nnorbik/robot_soubory/seznam_STL.pdf

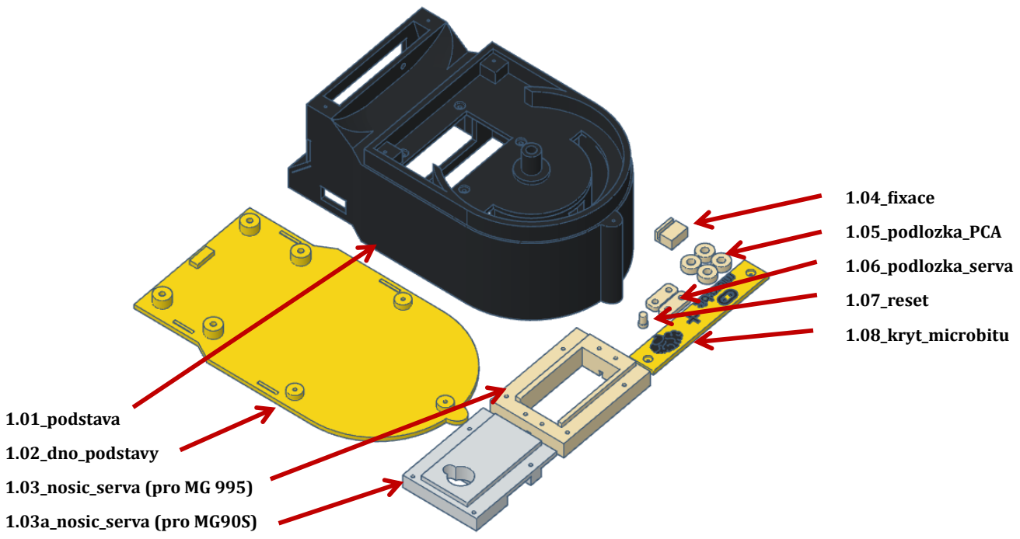
[picture p7: page 1]

1.01_podstava

1.02_dno_podstavy

1.03_nosic_serva (pro MG 995)

1.03a_nosic_serva (pro MG90S)

1.04_fixace

1.05_podlozka_PCA

1.06_podlozka_serva

1.07_reset

1.08_kryt_microbitu

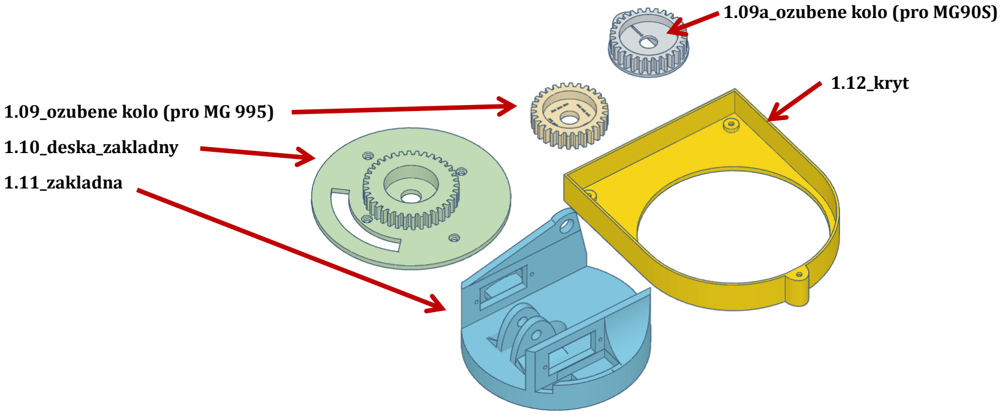
[picture p8: figure]
1.09_ozubene kolo (pro MG 995); 1.10_deska_zakladny; 1.11_zakladna; 1.09a_ozubene kolo (pro MG90S); 1.12_kryt
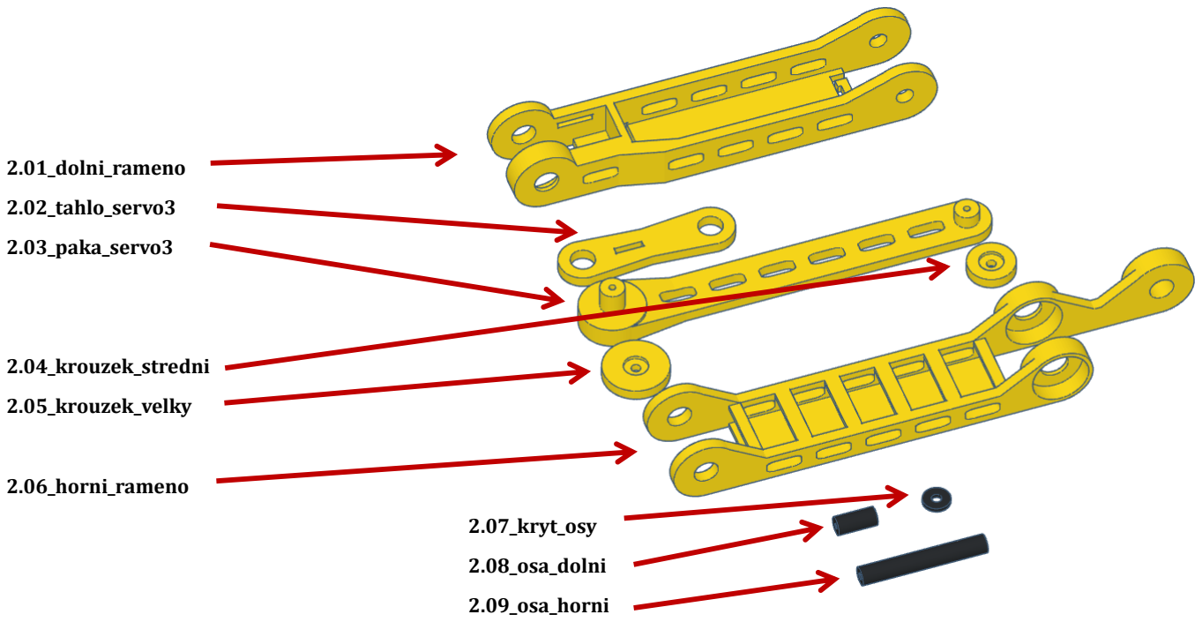
[picture p9: page 3]

2.01_dolni_rameno

2.02_tahlo_servo3

2.03_paka_servo3

2.04_krouzek_stredni

2.05_krouzek_velky

2.06_horni_rameno

2.07_kryt_osy

2.08_osa_dolni

2.09_osa_horni

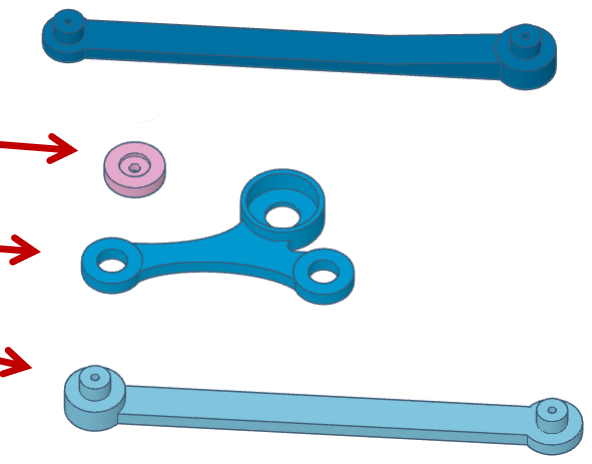
[picture p10: figure]

2.10_fix__dolni

2.11_krouzek_maly

2.12_paka

2.13_fix_horni

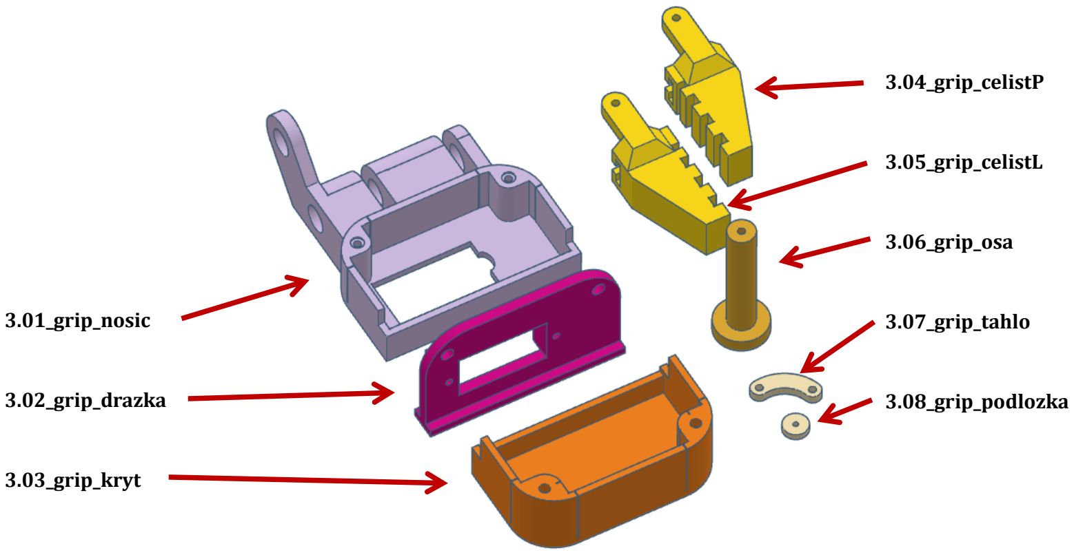
[picture p11: figure]
3.01_grip_nosic; 3.02_grip_drazka; 3.03_grip_kryt; 3.04_grip_celistP; 3.05_grip_celistL; 3.06_grip_osa; 3.07_grip_tahlo; 3.08_grip_podlozka
