nnorbik/robot_soubory/objekty/rampa.stl

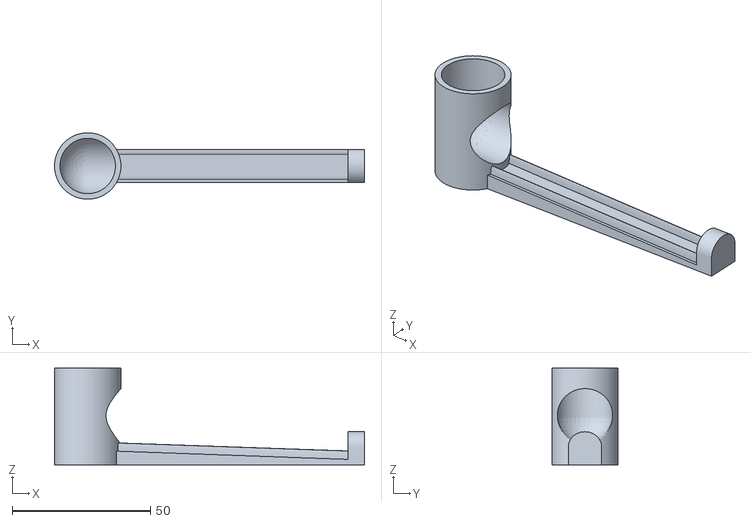
[picture p12: CAD file, 2023-05-19]
objekty/rampa.stl
112.0 x 24.0 x 35.0
