nnorbik/robot_soubory/STL/2.03_paka_servo3.stl

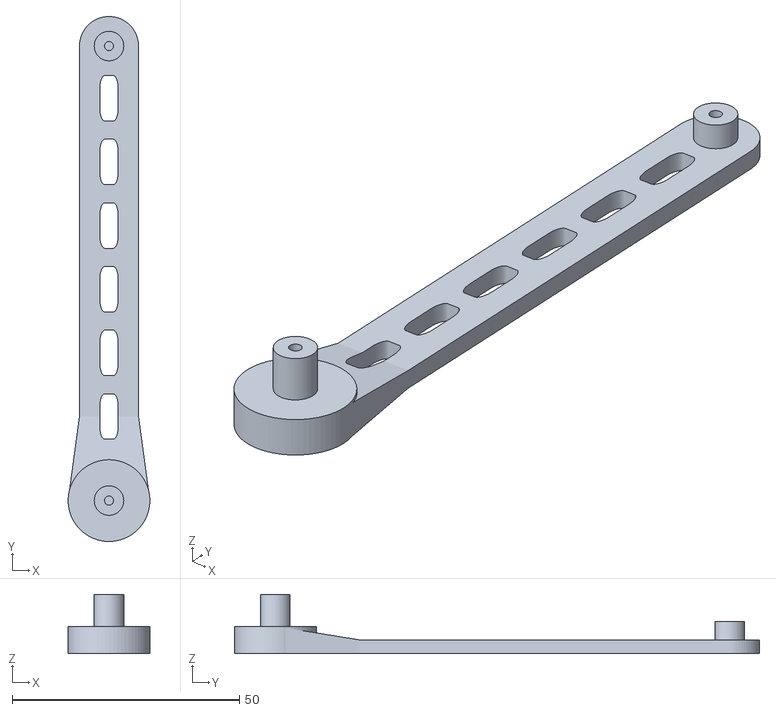
[picture p13: CAD file, 2023-04-25]
STL/2.03_paka_servo3.stl
18.0 x 115.5 x 13.0
