nnorbik/robot_soubory/objekty/zarazka.stl

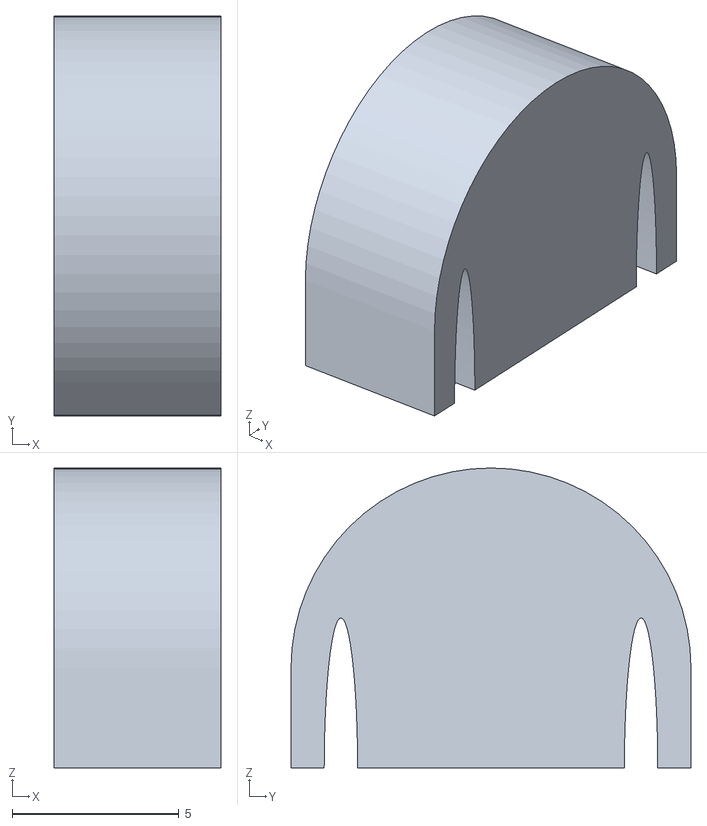
[picture p14: CAD file, 2023-05-19]
objekty/zarazka.stl
5.00 x 12.0 x 9.00
