nnorbik/robot_soubory/STL/2.07_kryt osy.stl

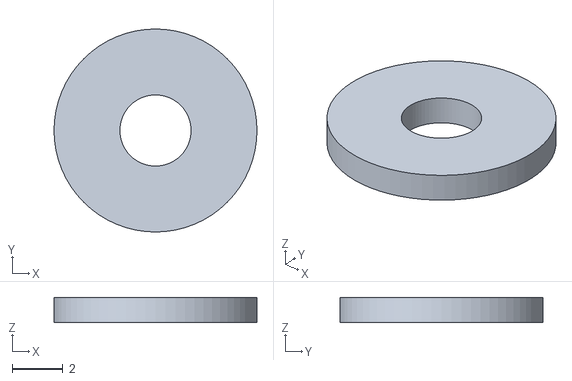
[picture p15: CAD file, 2023-04-25]
STL/2.07_kryt osy.stl
8.00 x 8.00 x 1.00
