nnorbik/robot_soubory/objekty/nastavec.stl

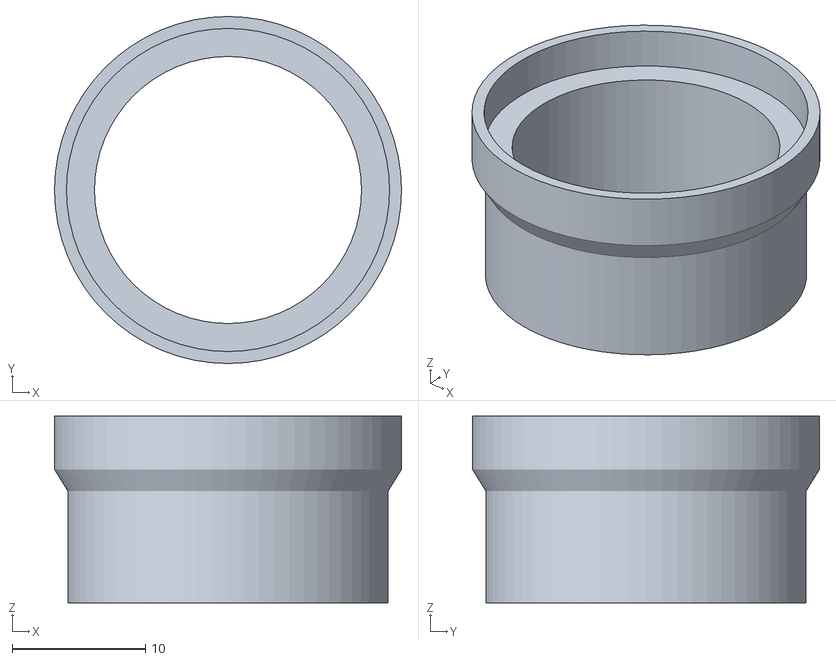
[picture p16: CAD file, 2023-05-19]
objekty/nastavec.stl
26.0 x 26.0 x 14.0
