nnorbik/robot_soubory/STL/3.08_grip_podlozka.stl

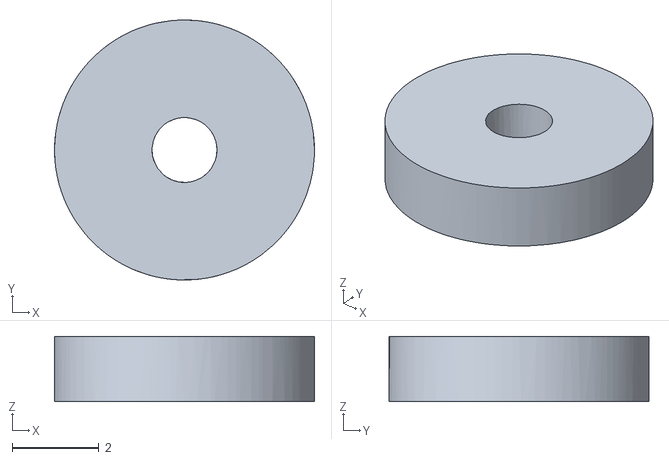
[picture p17: CAD file, 2023-04-25]
STL/3.08_grip_podlozka.stl
6.00 x 6.00 x 1.50
