nnorbik/robot_soubory/objekty/6uhelnik.stl

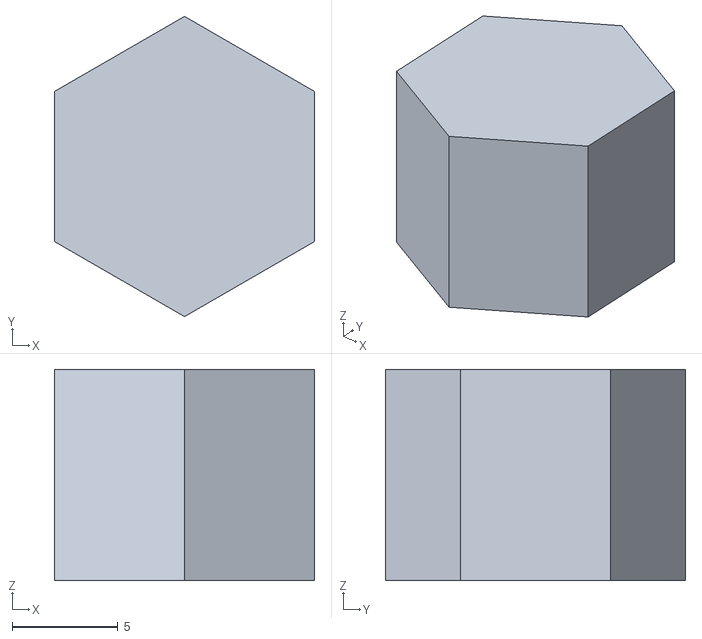
[picture p18: CAD file, 2023-05-19]
objekty/6uhelnik.stl
12.3 x 14.2 x 10.0
