nnorbik/robot_soubory/STL/1.03_nosic_serva.stl

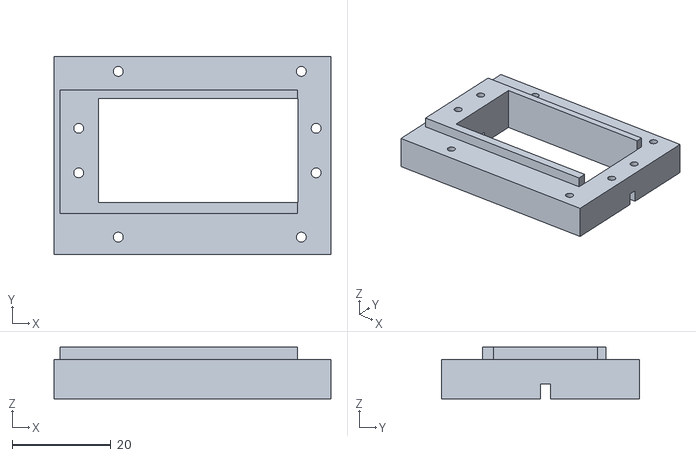
[picture p19: CAD file, 2023-04-25]
STL/1.03_nosic_serva.stl
56.0 x 40.0 x 10.5
