nnorbik/robot_soubory/objekty/kulicka.stl

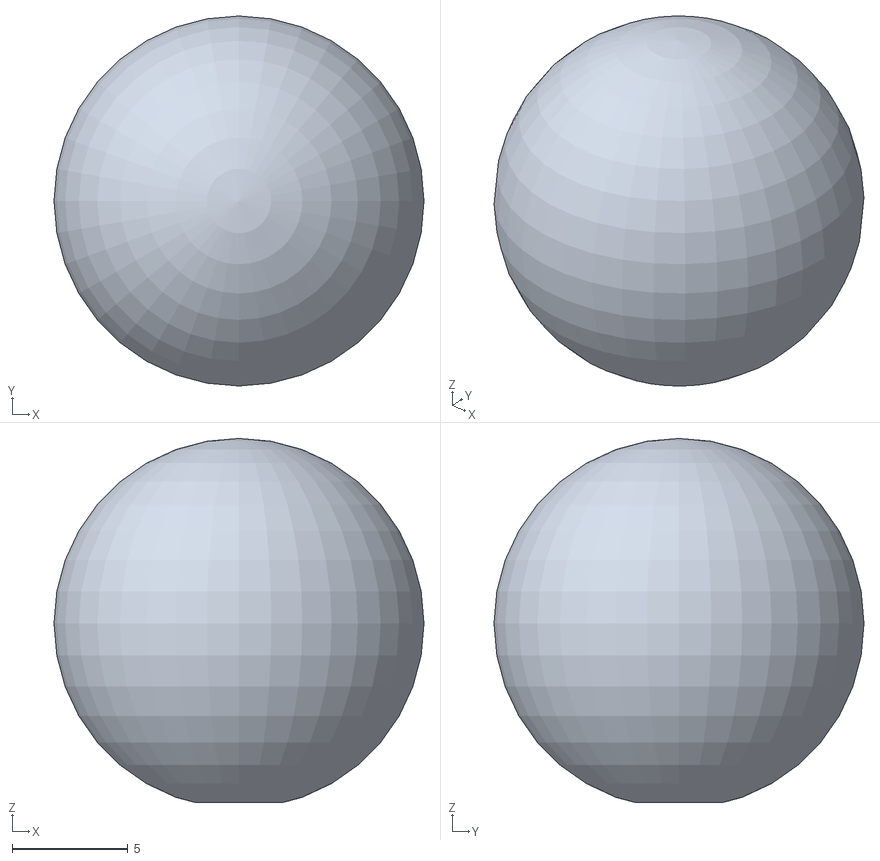
[picture p20: CAD file, 2023-05-19]
objekty/kulicka.stl
16.0 x 16.0 x 15.7
