nnorbik/robot_soubory/STL/3.02_grip_drazka.stl

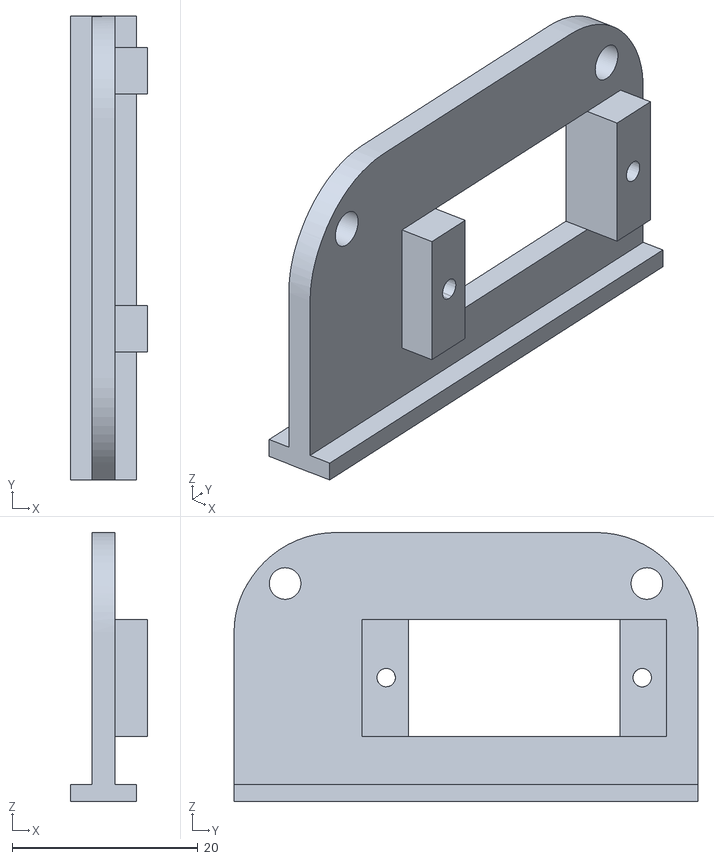
[picture p21: CAD file, 2023-04-25]
STL/3.02_grip_drazka.stl
8.30 x 50.0 x 29.0
