nnorbik/robot_soubory/STL/2.11_krouzek_stredni.stl

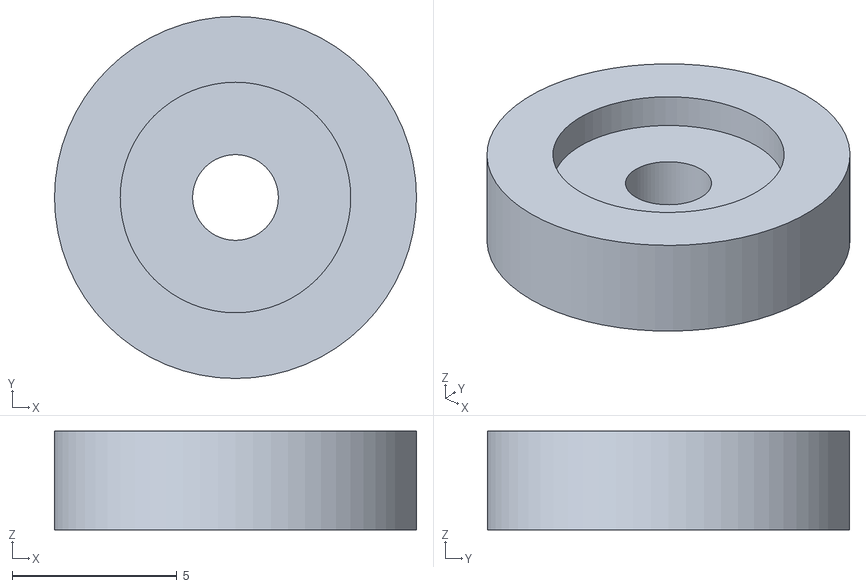
[picture p22: CAD file, 2023-04-25]
STL/2.11_krouzek_stredni.stl
11.0 x 11.0 x 3.00
