nnorbik/robot_soubory/STL/2.08_osa_dolni.stl

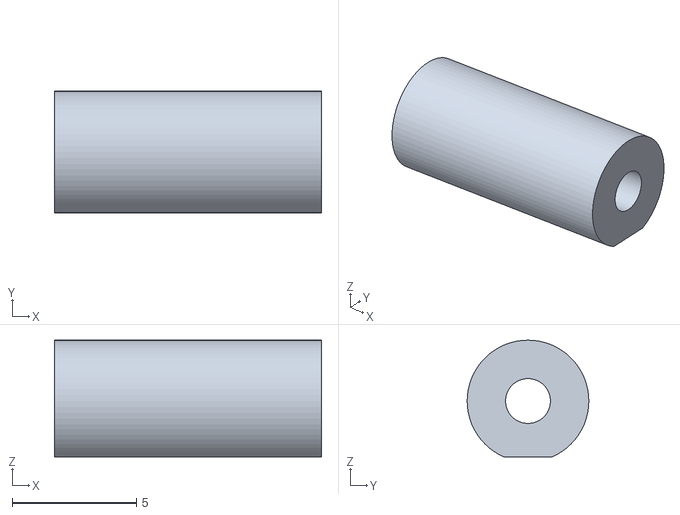
[picture p23: CAD file, 2023-04-25]
STL/2.08_osa_dolni.stl
10.8 x 4.90 x 4.70
