nnorbik/robot_soubory/STL/1.08_kryt_microbitu.stl

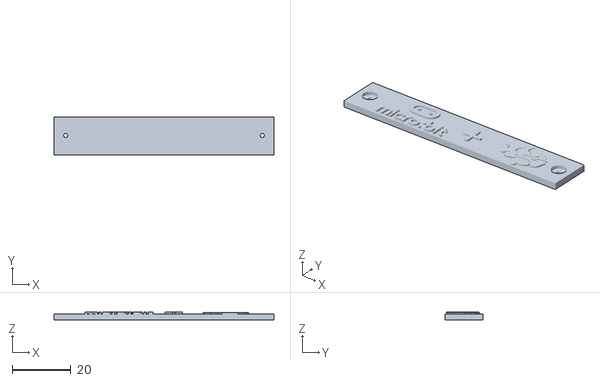
[picture p24: CAD file, 2023-04-25]
STL/1.08_kryt_microbitu.stl
75.0 x 13.0 x 2.60
