nnorbik/robot_soubory/STL/2.10_fix_dolni.stl

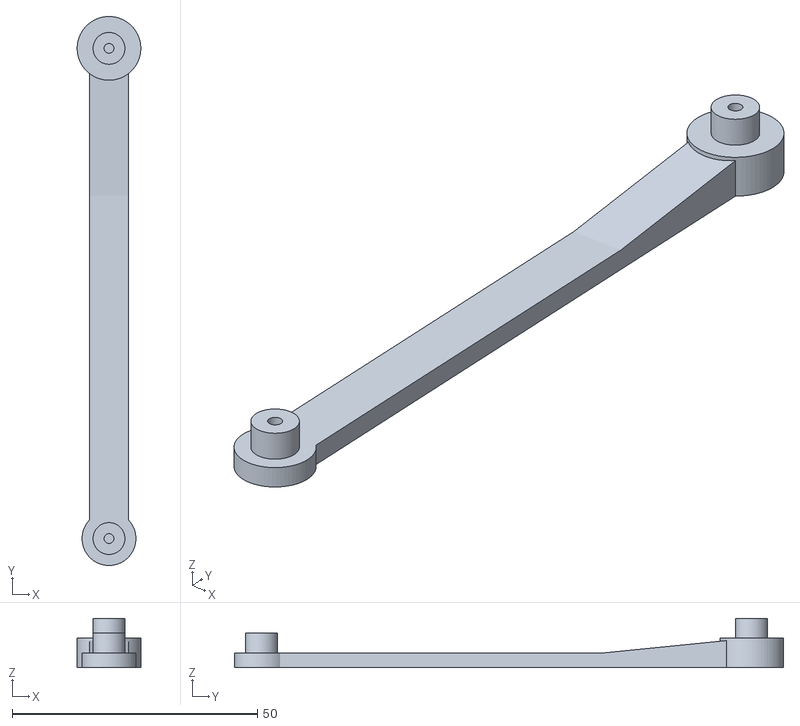
[picture p25: CAD file, 2023-04-25]
STL/2.10_fix_dolni.stl
13.0 x 112.0 x 10.00
