nnorbik/robot_soubory/STL/1.10_deska_zakladny.stl

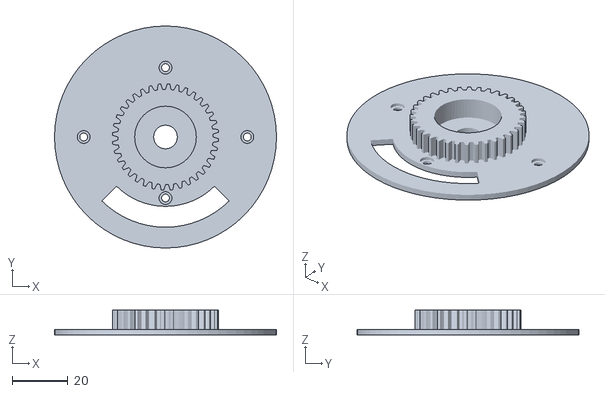
[picture p26: CAD file, 2023-04-25]
STL/1.10_deska_zakladny.stl
80.0 x 80.0 x 9.00
