nnorbik/robot_soubory/STL/1.04_fixace.stl

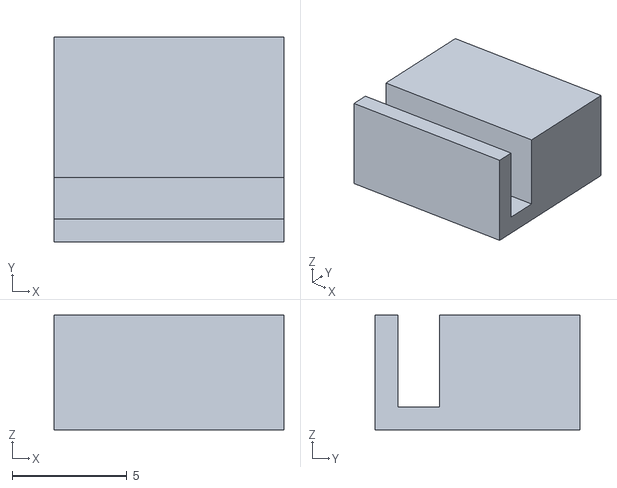
[picture p27: CAD file, 2023-04-25]
STL/1.04_fixace.stl
10.0 x 8.90 x 5.00
