nnorbik/robot_soubory/STL/1.01_podstava.stl

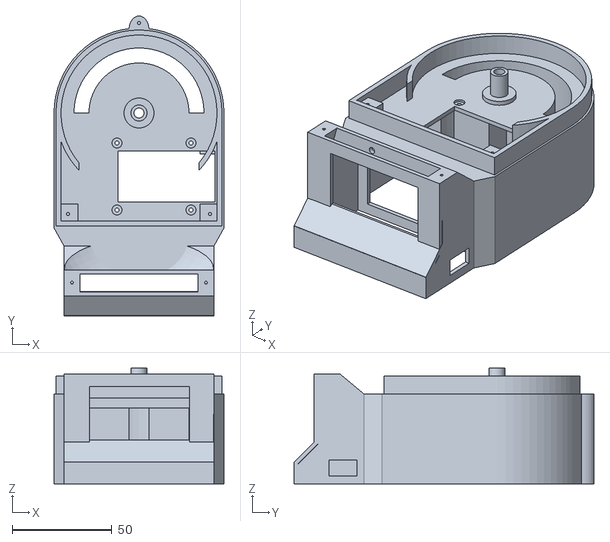
[picture p28: CAD file, 2023-04-25]
STL/1.01_podstava.stl
85.0 x 150.0 x 58.0
