nnorbik/robot_soubory/STL/3.07_grip_tahlo.stl

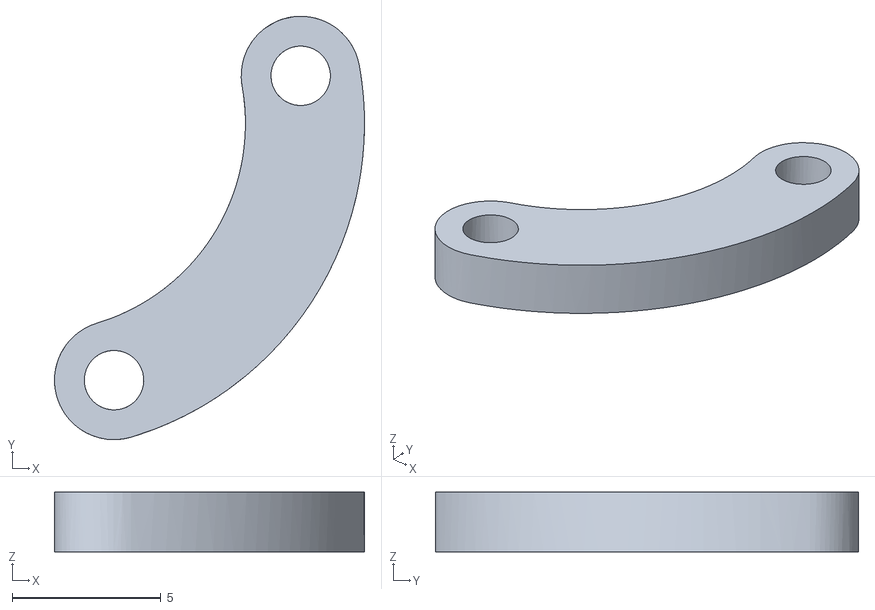
[picture p29: CAD file, 2023-04-25]
STL/3.07_grip_tahlo.stl
10.4 x 14.2 x 2.00
