nnorbik/robot_soubory/STL/2.04_krouzek_stredni.stl

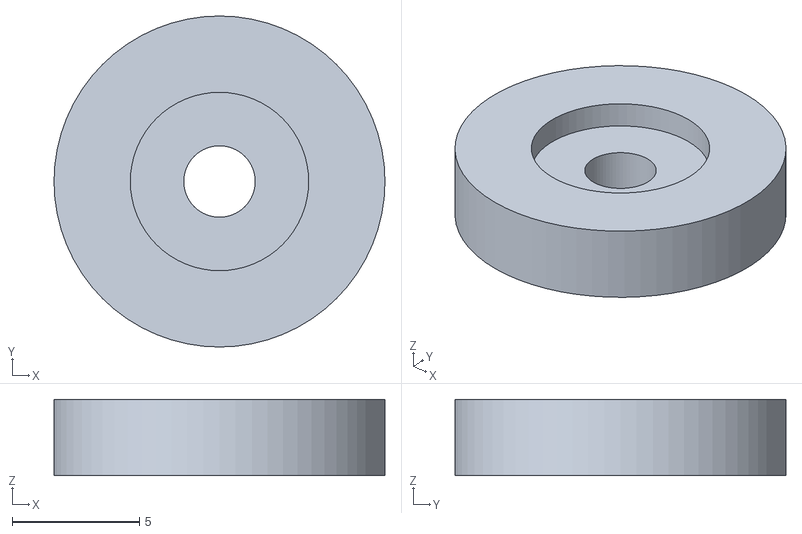
[picture p30: CAD file, 2023-04-25]
STL/2.04_krouzek_stredni.stl
13.0 x 13.0 x 3.00
