nnorbik/robot_soubory/STL/2.12_paka.stl

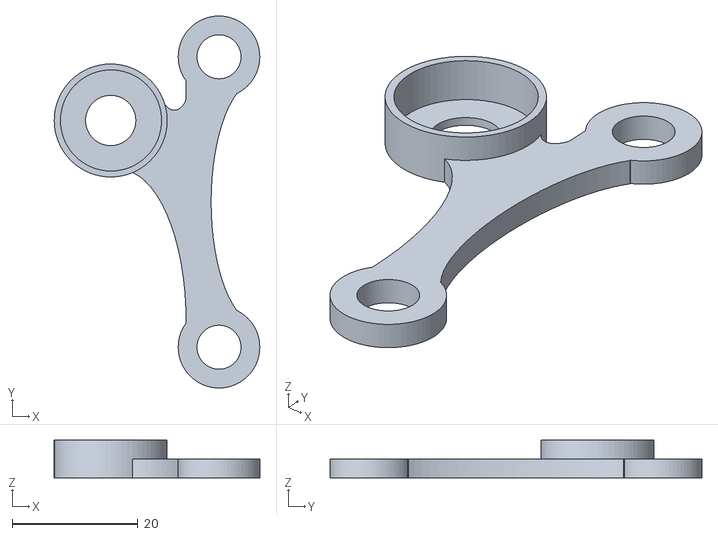
[picture p31: CAD file, 2023-04-25]
STL/2.12_paka.stl
32.8 x 59.2 x 6.00
