nnorbik/robot_soubory/STL/1.09_ozubene_kolo.stl

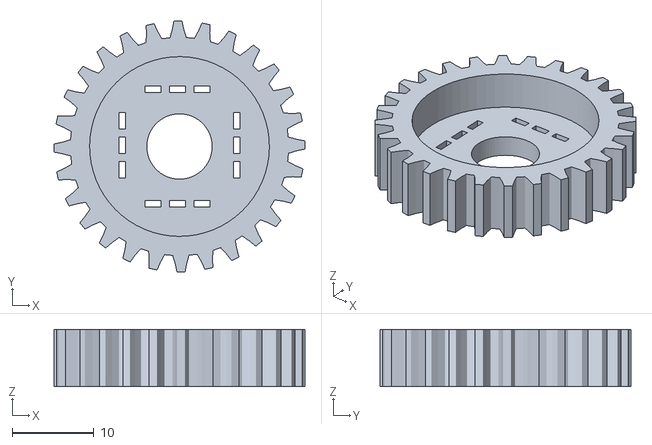
[picture p32: CAD file, 2023-04-25]
STL/1.09_ozubene_kolo.stl
30.7 x 30.7 x 7.00
