nnorbik/robot_soubory/STL/2.05_krouzek_velky.stl

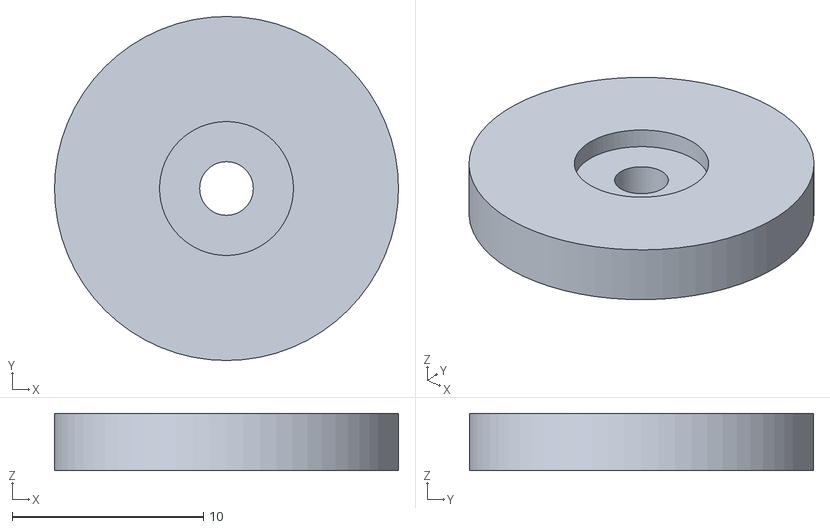
[picture p33: CAD file, 2023-04-25]
STL/2.05_krouzek_velky.stl
18.0 x 18.0 x 3.00
