nnorbik/robot_soubory/STL/3.05_grip_celistL.stl

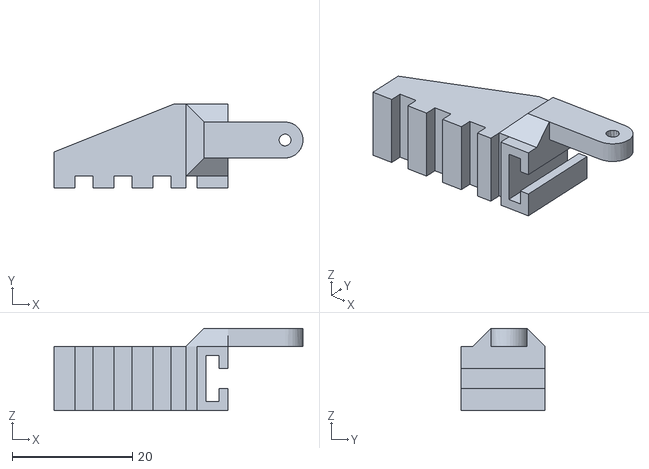
[picture p34: CAD file, 2023-04-25]
STL/3.05_grip_celistL.stl
41.5 x 14.0 x 13.7
