nnorbik/robot_soubory/STL/2.09_osa_horni.stl

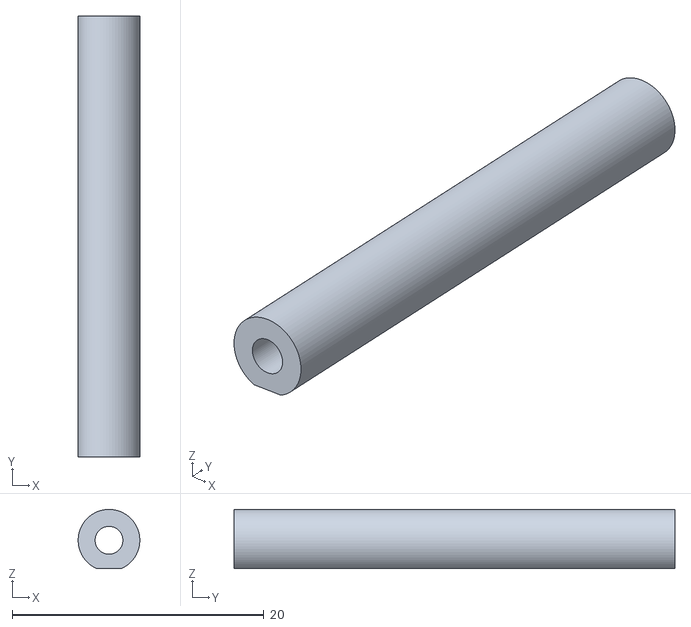
[picture p35: CAD file, 2023-04-25]
STL/2.09_osa_horni.stl
4.90 x 35.0 x 4.70
