nnorbik/robot_soubory/STL/1.05_podlozka_PCA.stl

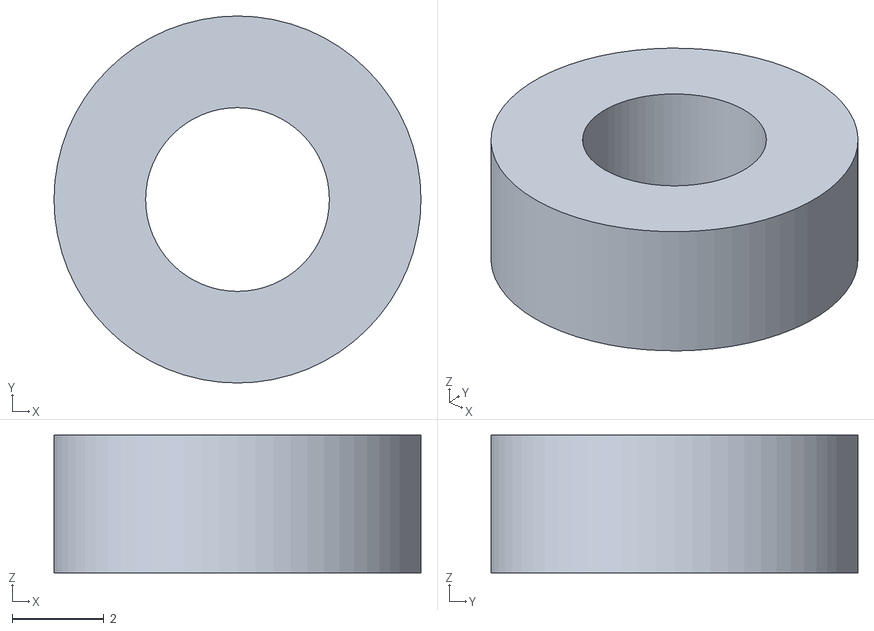
[picture p36: CAD file, 2023-04-25]
STL/1.05_podlozka_PCA.stl
8.00 x 8.00 x 3.00
