nnorbik/robot_soubory/STL/1.06_podlozka_serva.stl

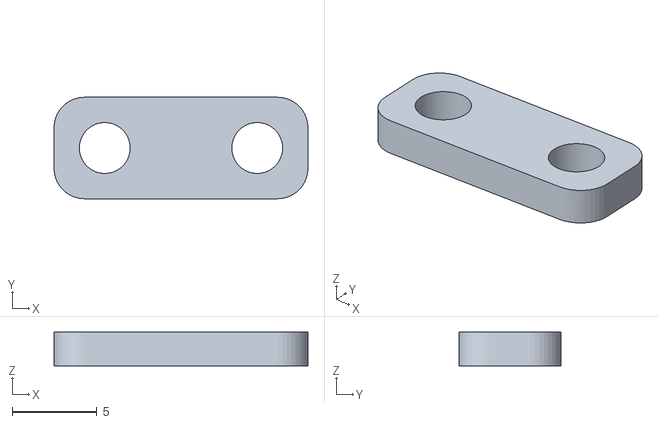
[picture p37: CAD file, 2023-04-25]
STL/1.06_podlozka_serva.stl
15.0 x 6.00 x 2.00
