nnorbik/robot_soubory/STL/1.02_dno.stl

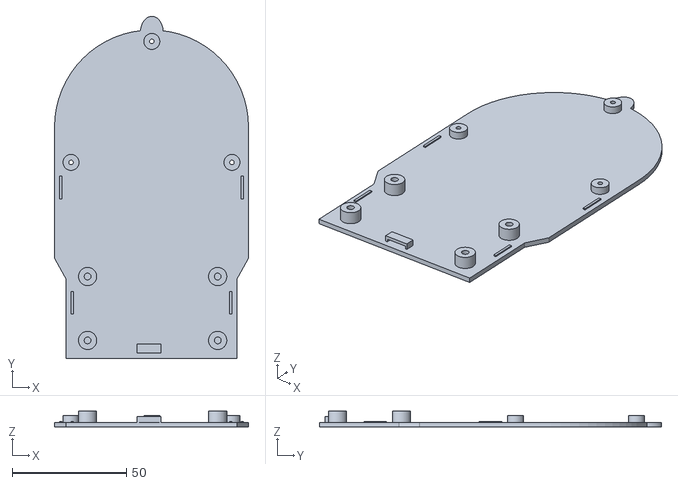
[picture p38: CAD file, 2023-04-25]
STL/1.02_dno.stl
85.0 x 150.0 x 7.00
