nnorbik/robot_soubory/STL/1.12_kryt.stl

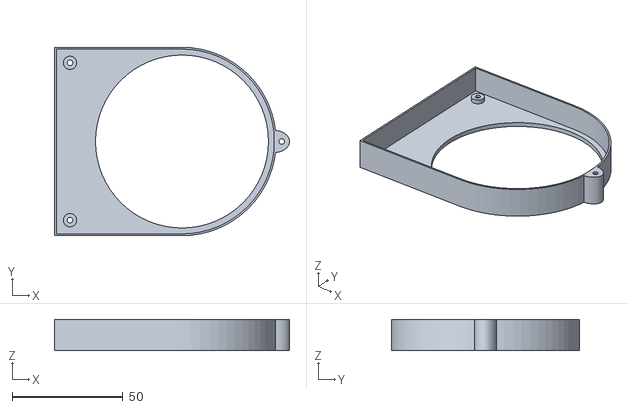
[picture p39: CAD file, 2023-04-25]
STL/1.12_kryt.stl
106.0 x 85.0 x 14.0
