nnorbik/robot_soubory/STL/3.01_grip_nosic.stl

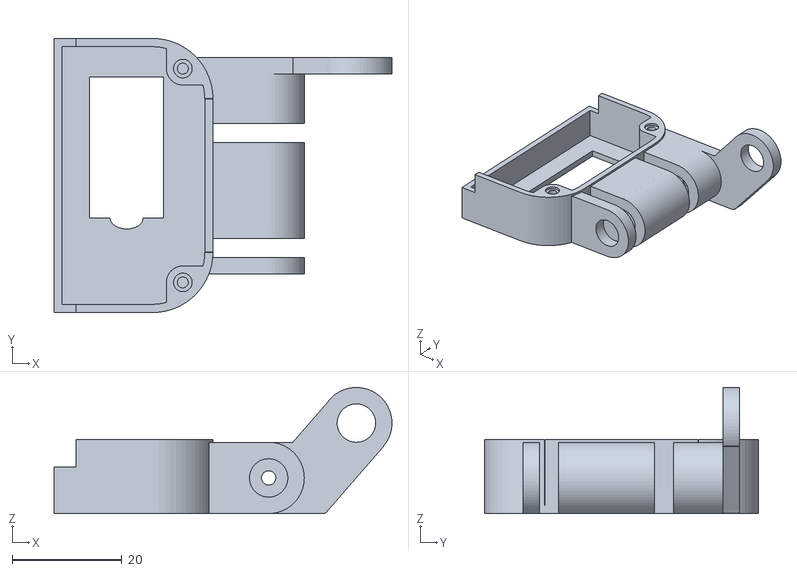
[picture p40: CAD file, 2023-04-25]
STL/3.01_grip_nosic.stl
61.7 x 50.0 x 23.0
