nnorbik/robot_soubory/STL/3.03_grip_kryt.stl

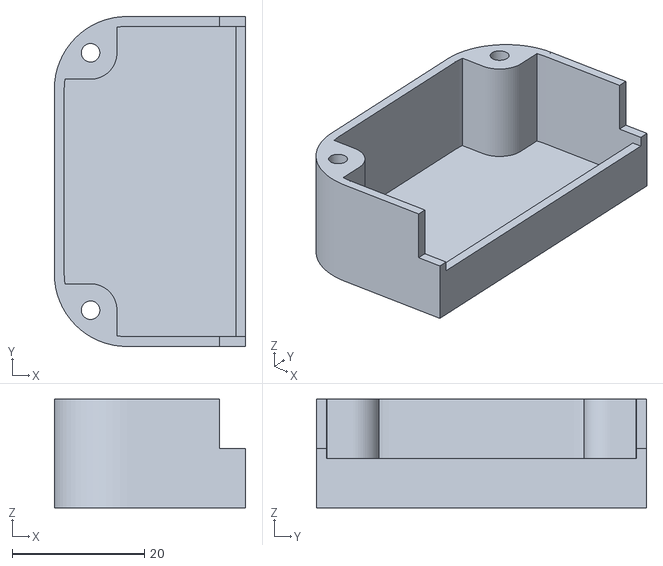
[picture p41: CAD file, 2023-04-25]
STL/3.03_grip_kryt.stl
29.0 x 50.0 x 16.5
