nnorbik/robot_soubory/STL/1.03a_nosic_serva.stl

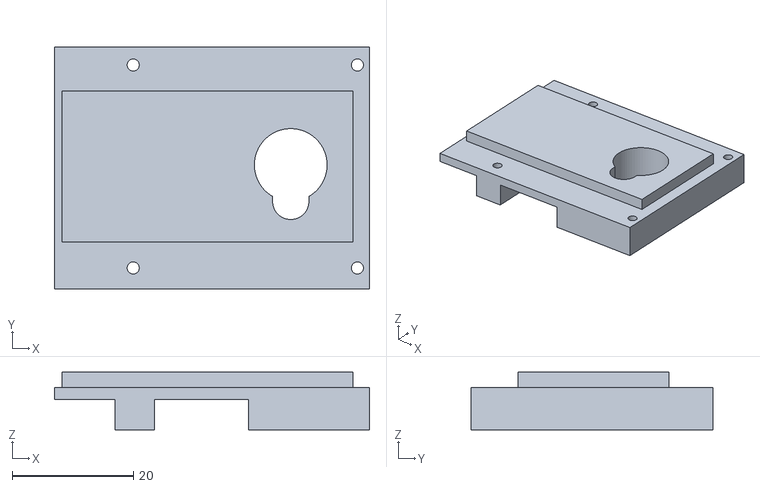
[picture p42: CAD file, 2023-04-25]
STL/1.03a_nosic_serva.stl
52.0 x 40.0 x 9.50
