nnorbik/robot_soubory/STL/1.07_reset.stl

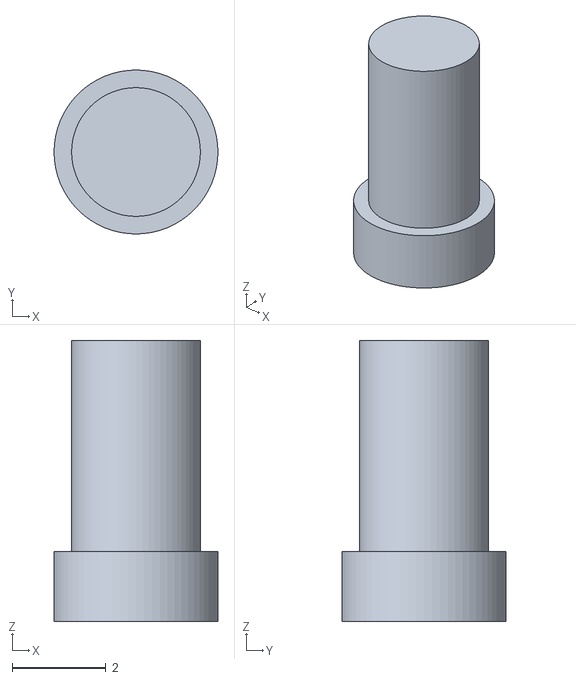
[picture p43: CAD file, 2023-04-25]
STL/1.07_reset.stl
3.50 x 3.50 x 6.00
