nnorbik/robot_soubory/STL/1.09a_ozubene_kolo.stl

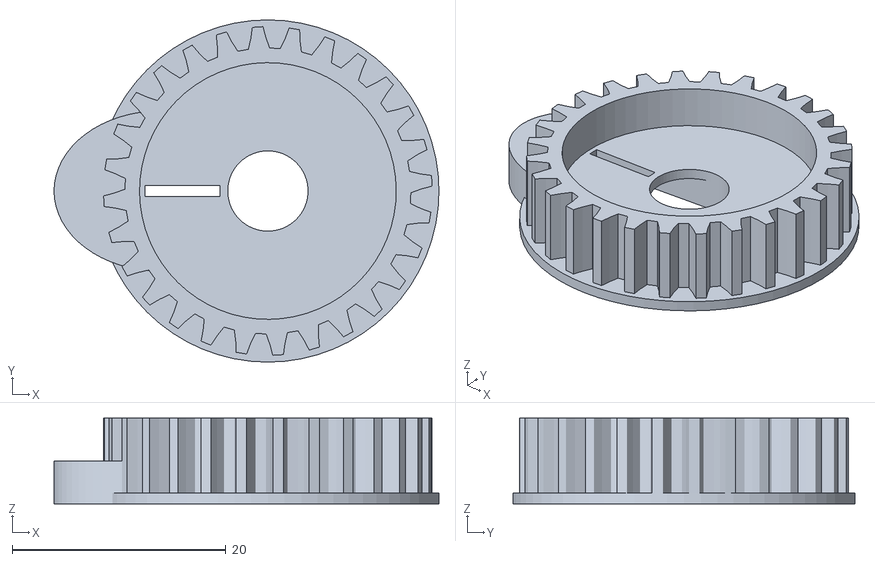
[picture p44: CAD file, 2023-04-25]
STL/1.09a_ozubene_kolo.stl
36.0 x 32.0 x 8.00
