nnorbik/robot_soubory/STL/1.11_zakladna.stl

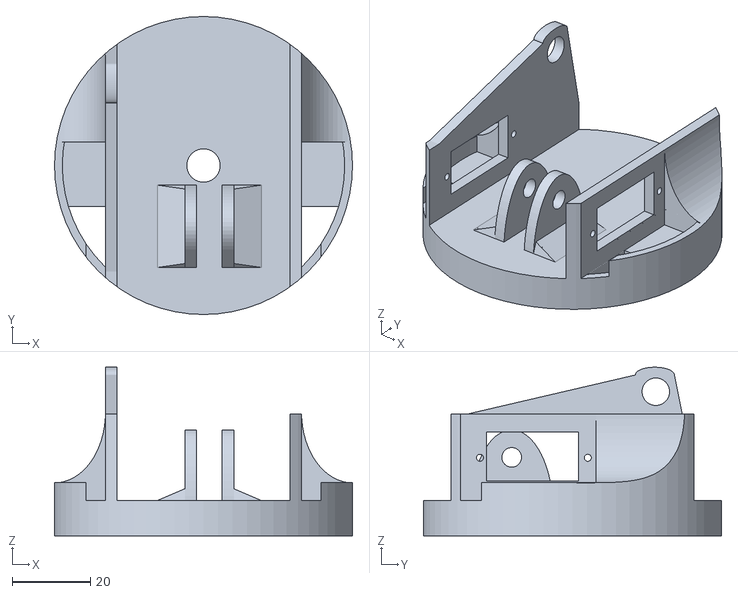
[picture p45: CAD file, 2023-04-25]
STL/1.11_zakladna.stl
76.0 x 76.0 x 43.0
