nnorbik/robot_soubory/STL/2.01_dolni_rameno.stl

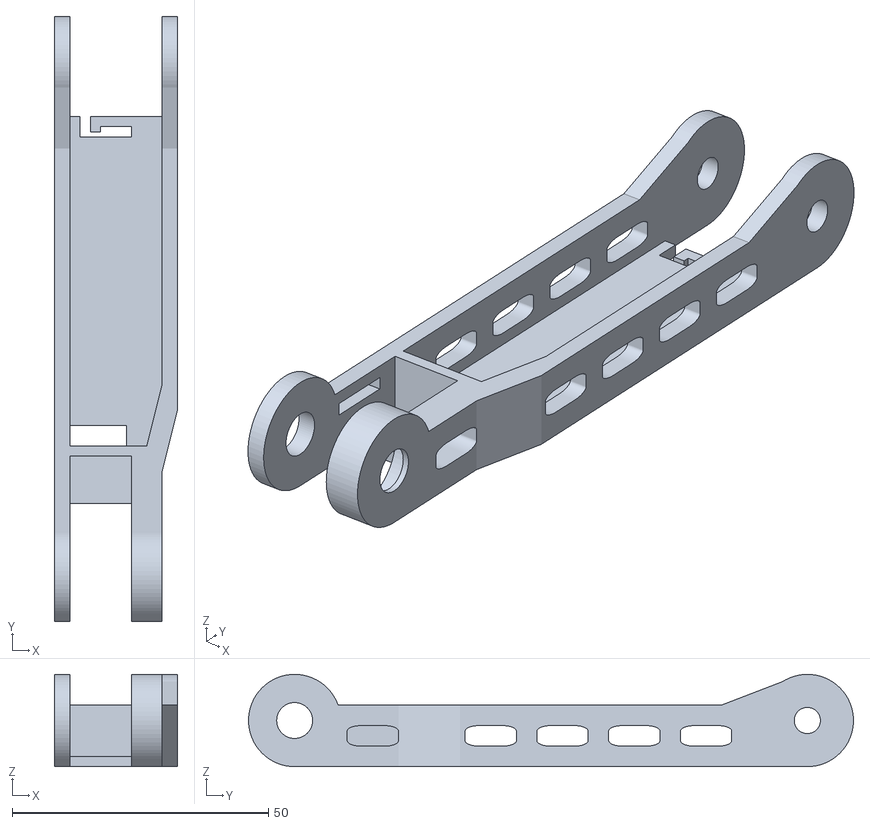
[picture p46: CAD file, 2023-04-25]
STL/2.01_dolni_rameno.stl
24.0 x 118.0 x 18.0
