nnorbik/robot_soubory/STL/3.06_grip_osa.stl

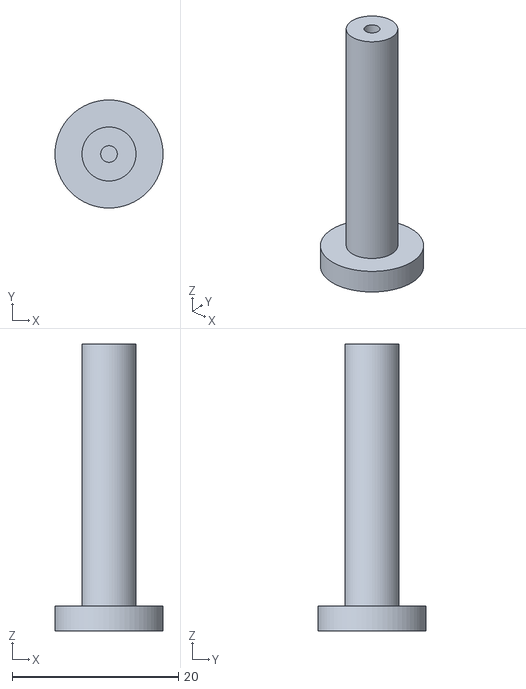
[picture p47: CAD file, 2023-04-25]
STL/3.06_grip_osa.stl
13.0 x 13.0 x 34.5
