nnorbik/robot_soubory/STL/2.02_tahlo_servo3.stl

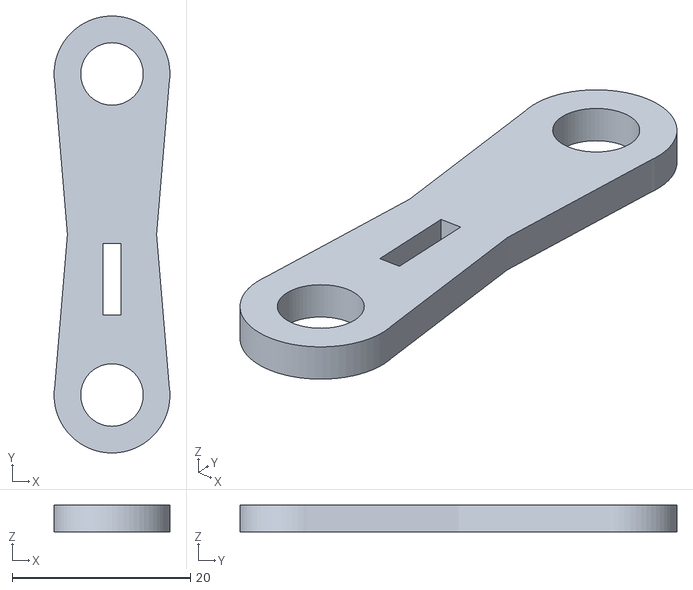
[picture p48: CAD file, 2023-04-25]
STL/2.02_tahlo_servo3.stl
13.0 x 49.0 x 3.00
