nnorbik/robot_soubory/STL/2.06_horni_rameno.stl

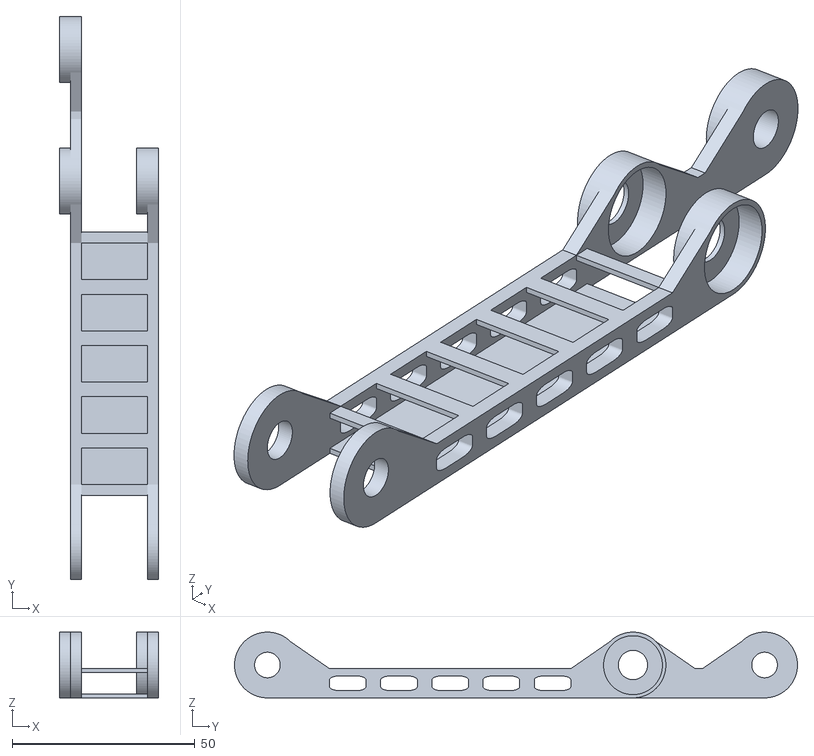
[picture p49: CAD file, 2023-04-25]
STL/2.06_horni_rameno.stl
27.0 x 154.0 x 18.0
