nnorbik/robot_soubory/(list of files, cad)

Other CAD files:
STL/2.13_fix_horni.stl
STL/3.04_grip_celistP.stl
